rinick/hexomino/box/Hexomino_Box_V1.md

# 两片式拼图收纳盒 V1-S：单边折叠、两端纵向闭合

2026-10-23。A 为固定高端墙，B 保留一体打印折叠端墙。底板改为四处 A 定位舌上下交错半搭接，舌厚 2.1 mm、承托台阶厚 1.7 mm。固定端承托舌与另一端翻盖扣边共同限制上下分离，侧扣主要防止盒盖滑退。展开后 A 最高 **40 mm**、B 端墙折下后最高约 **23.4 mm**；拼图区上方仍无遮挡。当前为可试打机械设计。

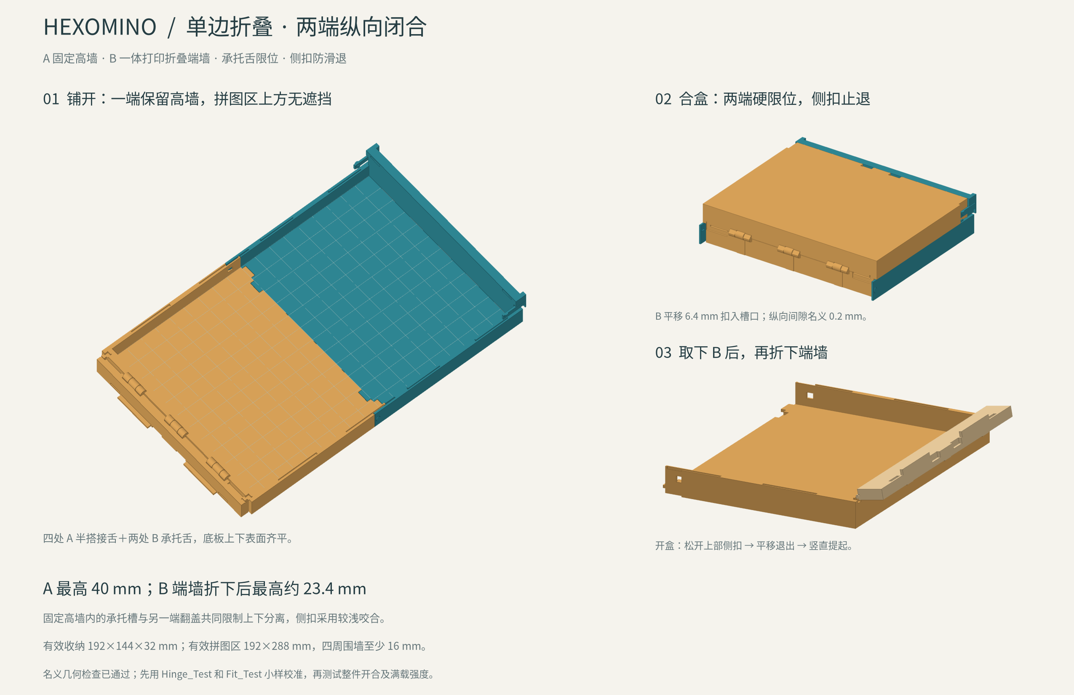
[picture p1: box/box_design.png]
拼板、闭盒和 B 端墙翻折


## 两片的形状

**A 是固定高墙托盘。** 底板 4 mm，两条长侧墙在底板以上高 16 mm，一条固定端墙到 Z=40 mm。固定墙的厚度内有两处承托台阶；墙的两侧各有一根上部弹臂，用于合盒止退。敞口处保留两根下部弹臂，用于拼板连接。

**B 是单边折叠托盘。** 底板和固定围墙与原版相同，端墙上半段由三组一体打印铰链连接。铺开时端墙向外翻下，固定围墙仍保留一格高度；合盒时端墙直立锁住，其扣边进入 A 底板的盲口。

A 为一个封闭实体；B STL 包含两个封闭壳体，即固定托盘和互锁的活动端墙。B 的塑料轴已经被轴套包住，不用金属轴或后装插销。正常打印不要把 B 两个壳体拆开重新摆盘或填掉活动缝。

整个 192×288 mm 拼图区底板以上没有内伸扣边、定位柱或连接件，所有拼块都能从正上方放入，包括跨接缝的位置。固定高墙上的承托槽位于 Y≥144 mm 的墙厚内，不伸进拼图区。

## 连接结构的分工

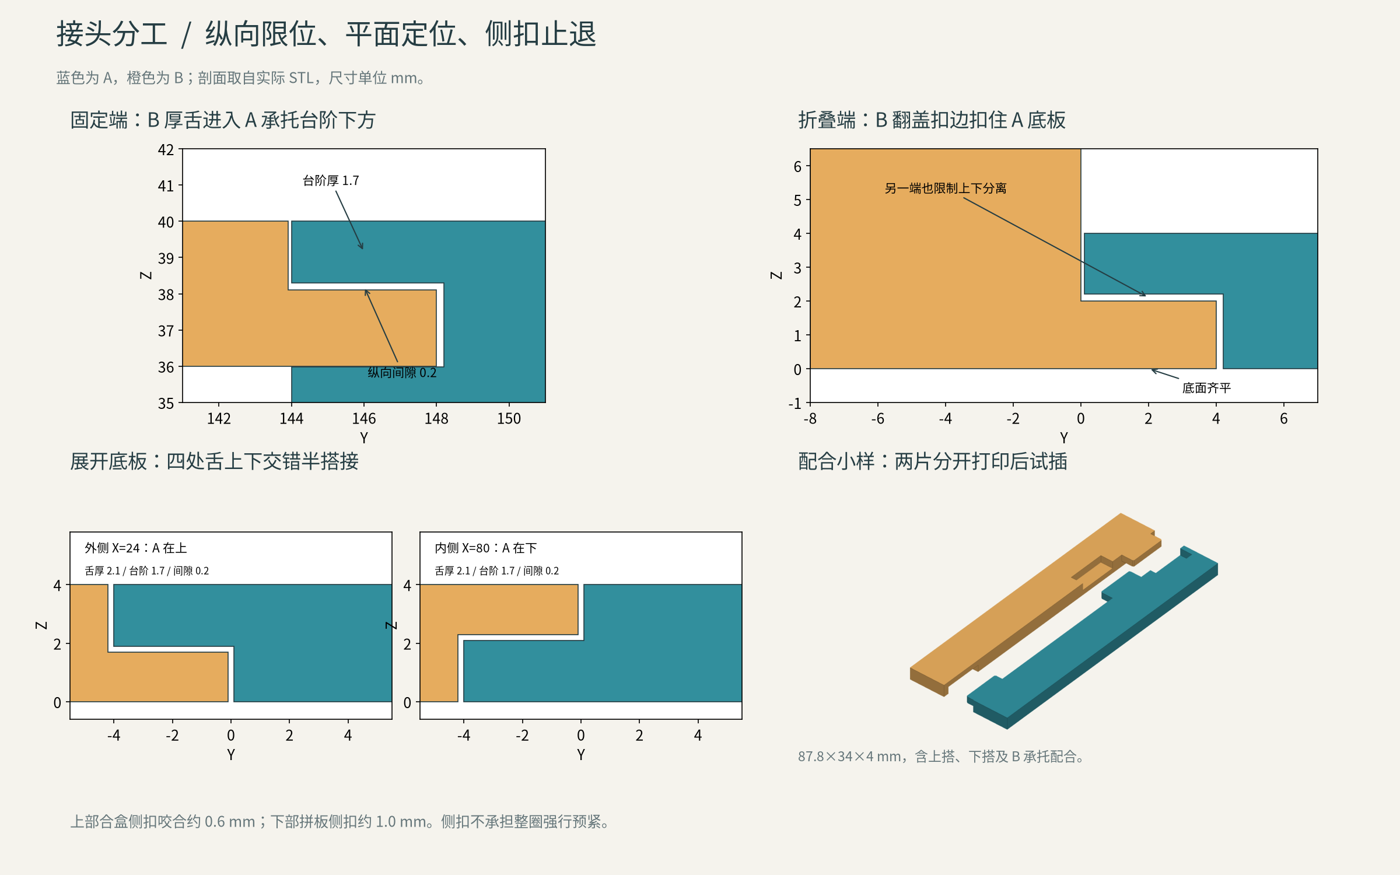
[picture p2: box/joints.png]
固定端承托、折叠端扣边与底板定位槽


| 结构 | 展开拼板时 | 合盒时 |
| --- | --- | --- |
| A 的四处矩形定位舌 | 与 B 底板的上下开放台阶半搭接，对齐接缝、限制错台 | 进入 B 端墙的让位口；开盖平移时退出 |
| B 的两处矩形承托舌 | 搭在 A 底板的下部台阶上，辅助定位 | 插到 A 固定高墙的承托台阶下方，限制上抬 |
| B 活动端墙的两段宽扣边 | 端墙折到外侧，不进入拼图区 | 扣住 A 底板的盲口，与固定端共同提供纵向闭合 |
| A 下部两只侧扣 | 扣入 B 的侧槽，防止拼板拉开 | 保持原位，不用于合盒止退 |
| A 上部两只侧扣 | 留在固定高墙外侧 | 复用 B 的同一组侧槽，主要防止 B 滑退 |
| 长侧墙的直舌和凹槽 | 位于围墙上缘 | 引导两片对齐，允许 6.4 mm 开盖平移 |

**纵向闭合由刚性承靠面承担。** 固定端的两处 B 舌翻面后位于 A 高墙承托台阶下方，台阶厚 1.7 mm，限制 B 上抬；另一端的翻盖扣边扣住 A 底板。长侧墙的合拢承靠面限制 B 下沉。两端防上抬配合的名义间隙都约 0.20 mm。这是留隙限位，不是依靠弹片强行预紧整盒；实际松紧需试打校准。

**侧扣负责止退。** 下部拼板侧扣的横向咬合约 1.0 mm，保留原强度定位。上部合盒侧扣咬合改为约 0.6 mm，释放行程约 0.8 mm；增加导入斜面，目标是减轻解扣力度。弹片实际力和寿命尚未做载荷验证。

**底板矩形舌作定位和错台限位。** A 四处舌中心位于 X=24、80、112、168 mm，左右对称并避开翻盖扣边。外侧两处在底板上部（Z=1.9–4 mm），内侧两处在下部（Z=0–2.1 mm）；对应 B 台阶分别在下方和上方，交错限制相对上抬和下沉。B 两处承托舌仍位于 X=8、184 mm，均在底板上部。所有矩形舌宽 12 mm、伸出 4 mm、厚 2.1 mm；对应台阶厚 1.7 mm，接触方向留 0.20 mm 间隙，即 2.1+0.2+1.7=4 mm。

原来的中置薄舌和全包盲槽改为单面开放搭接，端部保留平面导入倒角，没有梯形倒扣。舌的厚度略大于台阶，台阶仍保留 1.7 mm；不通过继续削薄台阶来增厚舌头。搭接后的顶面和底面与 4 mm 底板齐平，只有配合缝，不在拼图面增加凸起。底板搭接负责定位，主要抗拉连接仍由侧扣承担。

## 开合和转换顺序

**组成拼图板**：把空 B 正放在桌面，解开它的端墙弹片并向外折下；将 B 在板面内转 180°，与 A 敞口相对；沿桌面靠拢，让上下交错的矩形舌与台阶搭接，直到左右下部侧扣进入 B 窗口。两块 4 mm 底板齐平，中央接缝约 0.2 mm。解除时，拨开下部两只侧扣后沿板面拉开，不要直接向上掰接缝。

**组成收纳盒**：先分开拼板，按两层排布将全部拼块装入 A；把 B 活动端墙翻起，确认两端弹片锁住，再将空 B 翻面。B 相对最终位置向开口外侧错开约 6.4 mm，水平放到 A 上，对准长边导向槽；再沿板面滑入 6.4 mm，让固定端承托舌、另一端扣边和底板定位舌分别进入槽口，上部侧扣扣入 B 窗口。上部侧扣的导入面用于让位，必要时轻拨弹臂辅助扣合。

**开盒**：水平放置盒子，拨开 A 的两只上部侧扣，将 B 向开口外侧滑出约 6.4 mm，再竖直提起 B。取下 B 后，按需要翻面并折下它的端墙。闭盒时保持 B 端墙锁住，不直接翻它来开盒；否则矩形定位舌和扣边仍在槽内。

B 仍是浅托盘，开盖时上层拼块没有四面两格高的完整围墙包住，因此需要水平开盒。收纳沿用 [两层排布图](packing_12x9x2.png) 和 [排布数据](packing_12x9x2.json)：下层 19 块、上层 18 块，各 108 格。37 个拼块及每面 0.10 mm 打印间隙不变。

## B 的一体打印铰链

沿端墙分布三组铰链，中心 X=40、96、152 mm。塑料轴最大直径 2.4 mm，轴套圆孔直径 3.2 mm，最小径向和轴向间隙均约 0.40 mm。打印姿态已把端墙折下，孔顶采用约 45° 尖顶；轴下侧切平，仍需完成约 10 mm 的短桥接。

活动片上的三条筋接触打印床，支承活动轴套。两端弹片锁住直立位置；解扣后弹片沿限位台外侧滑开。打印活动间隙和释放力需先用 `Hinge_Test.stl` 校准。

## 尺寸

| 项目 | 尺寸 |
| --- | --- |
| 合盒完整有效空间 | 192×144×32 mm，12×9×2 格 |
| 展开拼图有效区域 | 192×288 mm，12×18 格 |
| 底板 / 长侧墙厚度 | 4 / 4 mm |
| 端墙主体厚度 | 8 mm |
| 围墙在底板以上的高度 | 至少 16 mm，A 固定端墙为 36 mm |
| A 单件打印外包 | 约 202.0×169.6×40 mm |
| B 单件打印外包，端墙折下 | 约 200.0×168.8×23.4 mm |
| 合盒外包，含侧面突出结构 | 约 202.0×169.6×40 mm |
| 展开外包，含折下端墙 | 约 202.0×320.4×40 mm |
| A 定位舌数量 | 4，外侧两处上搭、内侧两处下搭 |
| 矩形舌宽度 / 伸出 / 厚度 | 12 / 4 / 2.1 mm |
| 底板对应台阶 / 固定高墙承托台阶厚度 | 均为 1.7 mm |
| 搭接方向间隙 | 0.20 mm |
| 铰链小样 | 约 64×36.8×23.4 mm |
| 矩形配合小样 | 约 87.8×34×4 mm，两片分开放置 |

闭盒上下大面仍为 Z=0 和 40 mm 的平面，槽口处保留配合缝；侧面允许铰链、弹片和端墙支承凸出。

## 打印与试打

先打印 `STL/Hinge_Test.stl` 和 `STL/Fit_Test.stl`，使用与主体相同的材料、喷嘴和层高。前者含一组 B 铰链、端墙锁扣和一处定位舌让位口；后者含 A 上搭舌、下搭舌，以及 B 承托舌与对应台阶，两块小样已经分开放置，打印后沿板面试插。

A、B 都按 STL 当前姿态打印，底板外表面朝下。**A 上部两根水平弹臂下方需要局部、可清理的支撑**；弹臂底部位于 Z=25.6 mm，根部与固定墙连接。清理后检查弹臂下方、背后和上方间隙，不能把弹臂与周围墙面补实。可先在切片软件截取上部侧扣区域试打，检查支撑能否完整去除和约 0.8 mm 的释放行程。

下部定位舌接触打印床；A 的两处上部定位舌、B 的两处承托舌底面在 Z=1.9 mm，向外悬挑 4 mm，需按实际切片检查并添加可清理的局部支撑。固定高墙承托台阶的底面也需检查桥接和支撑效果。不得将搭接间隙填实。

B 的铰链活动缝内不要布支撑。检查塑料轴的短桥接和轴套孔顶，不能将两个活动壳体布尔合并。配合受材料和设备影响，需要小样迭代校准，参见 [Prusa 打印建模说明](https://help.prusa3d.com/article/modeling-with-3d-printing-in-mind_164135)。

完成小样后再打印完整主体，依次检查空盒滑入退出、两端纵向间隙、侧扣释放、满载拿取及反复开合。本文的刚性分工是几何设计，尚不代表已验证的满载强度或疲劳寿命。

## 几何验证与文件

`validation_results.json` 保存源码及四个 STL 的 SHA-256，验证内容为：

- A 一个、B 两个、两种小样各两个封闭且法向一致的壳体。
- 合盒、展开状态的顶点分层中点截面无实体面积重叠，截面数量记录在报告中。
- 实测四处 A 舌厚 2.1 mm、对应台阶厚 1.7 mm、间隙 0.20 mm；尝试将 B 上移和下移各 0.25 mm，均出现预期接触，确认双向错台限位。
- 取下 B 后，端墙在 183 个角度的截面内无刚体干涉；解扣阶段用约 1 mm 弹片挠动近似。
- B 错位下放检查 61 个位置，平移闭合检查 33 个位置，合盒侧扣释放检查 9 个位置，均无干涉。
- 拼板滑入检查 49 个位置、侧扣释放检查 13 个位置，均无干涉。
- 完整收纳空间无侵入，192×288 mm 拼图区底板以上投影无遮挡。
- 在闭盒状态尝试把 B 上提 0.25 mm，固定墙槽顶出现预期接触，确认纵向硬止挡存在；这不是承载强度试验。

侧扣让位采用近似几何位移，没有模拟实际弹性形变、切片、收缩、磨损或载荷。源码仍为 `hexomino_box_v1.scad`；`view="board"`、`"box"`、`"folding"` 查看三种状态，`fold_angle` 仅影响 B。`component="fixed"`、`"flap"` 仅用于壳体检查，正常保持 `"all"`。

```sh
openscad --backend=CGAL --hardwarnings --export-format=binstl -D 'part="A"' -o box/STL/Tray_A.stl box/hexomino_box_v1.scad
openscad --backend=CGAL --hardwarnings --export-format=binstl -D 'part="B"' -o box/STL/Tray_B.stl box/hexomino_box_v1.scad
openscad --backend=CGAL --hardwarnings --export-format=binstl -D 'part="coupon"' -o box/STL/Hinge_Test.stl box/hexomino_box_v1.scad
openscad --backend=CGAL --hardwarnings --export-format=binstl -D 'part="fit_coupon"' -o box/STL/Fit_Test.stl box/hexomino_box_v1.scad
python box/validate_geometry.py
```

验证脚本需要 NumPy、trimesh、Shapely、SciPy。旧版可从 Git 历史查看，当前打印文件均在 `box/STL/`。
