rinick/hexomino/ALL_37_SHAPES.png

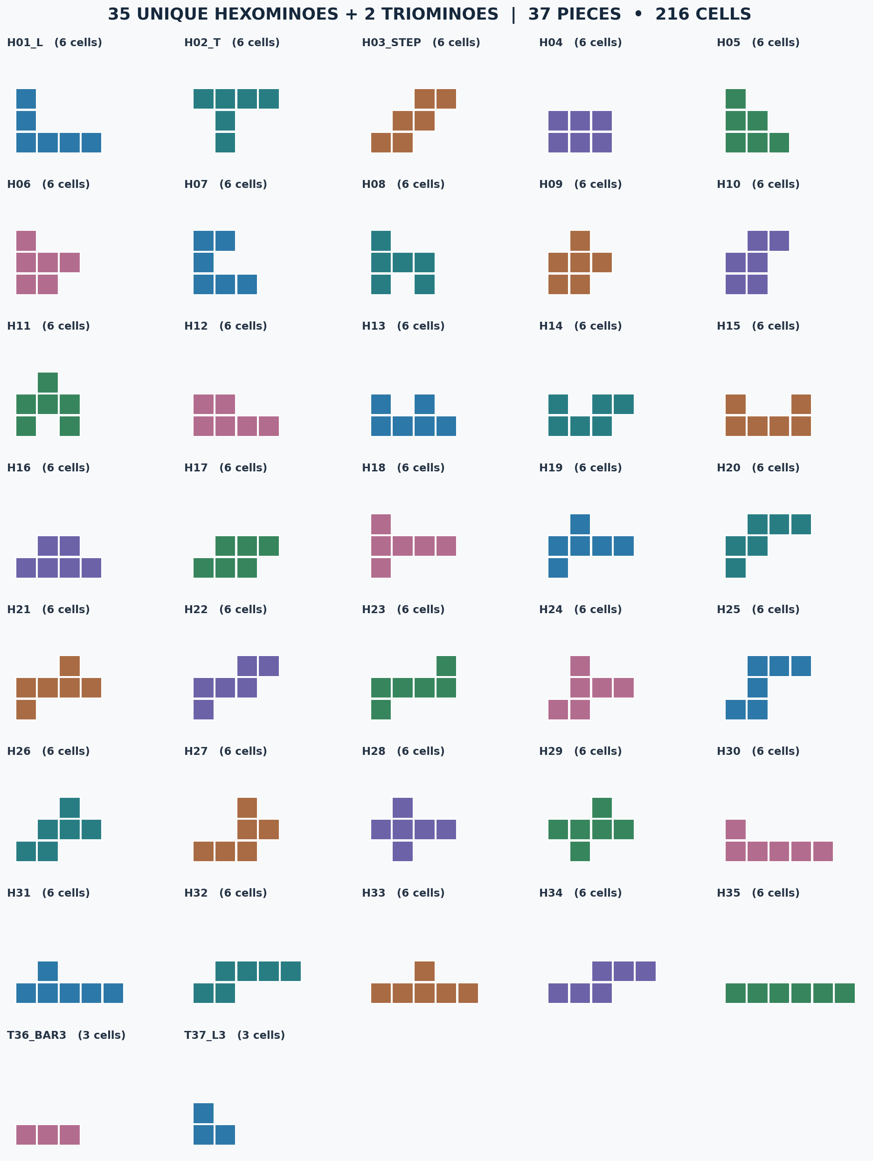
ALL_37_SHAPES.png
