rinick/hexomino/box/packing_12x9x2.png

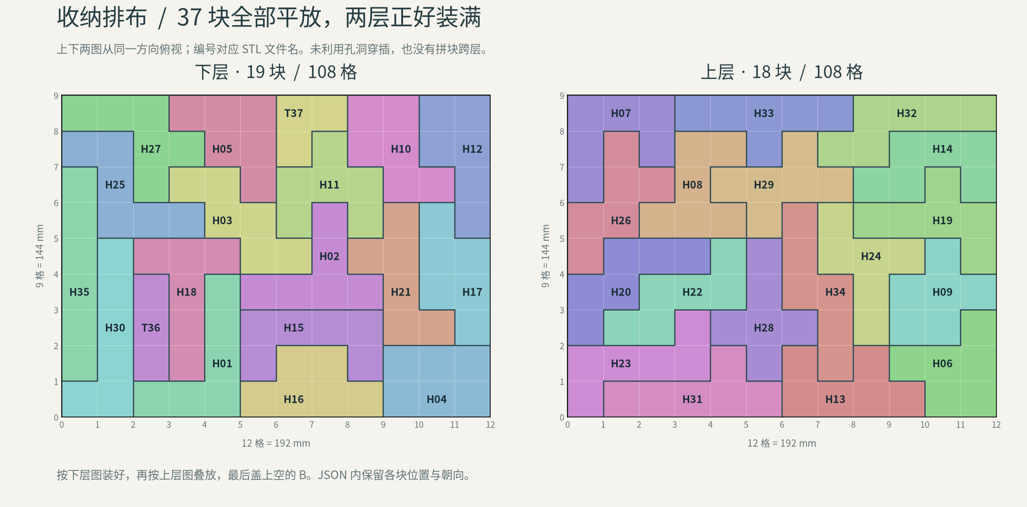
box/packing_12x9x2.png
