rinick/hexomino/V6_3_5_PREVIEW.png

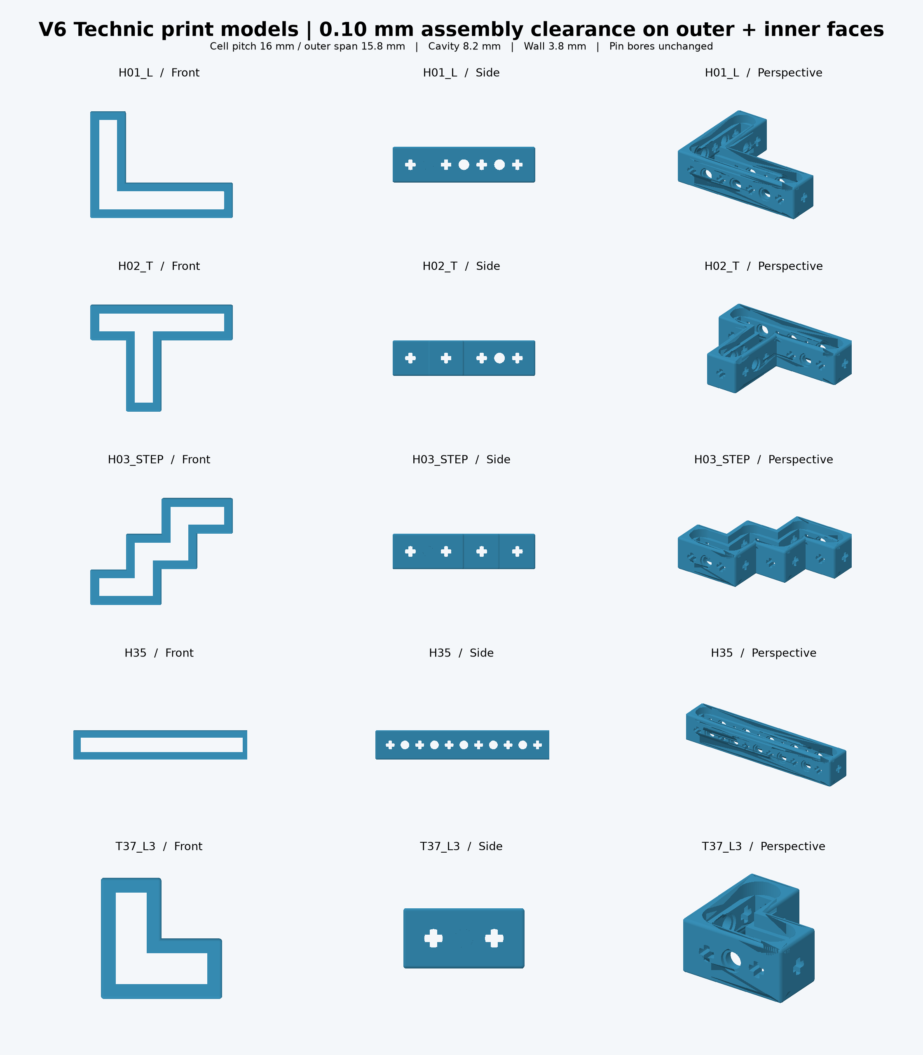
V6_3_5_PREVIEW.png
