rinick/hexomino/box/STL/Tray_A.stl

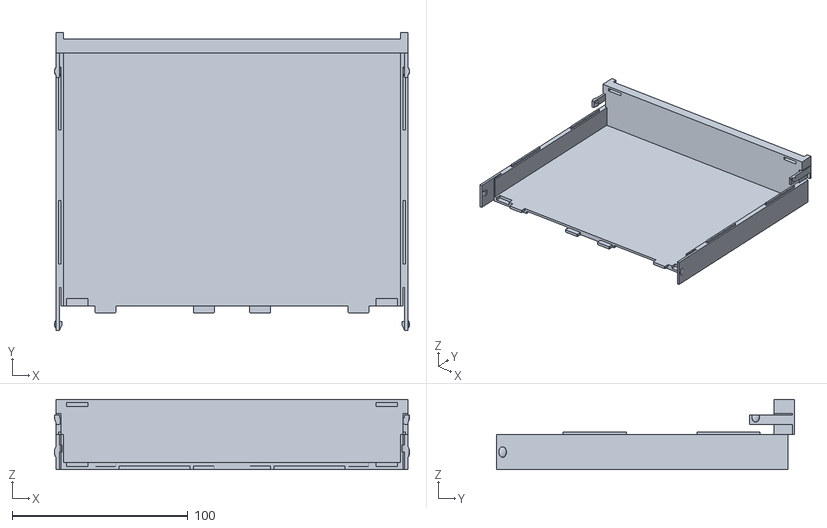
[picture p6: CAD file, 2026-10-23]
box/STL/Tray_A.stl
202.0 x 169.6 x 40.0
