rinick/hexomino/STL_37/T36_BAR3.stl

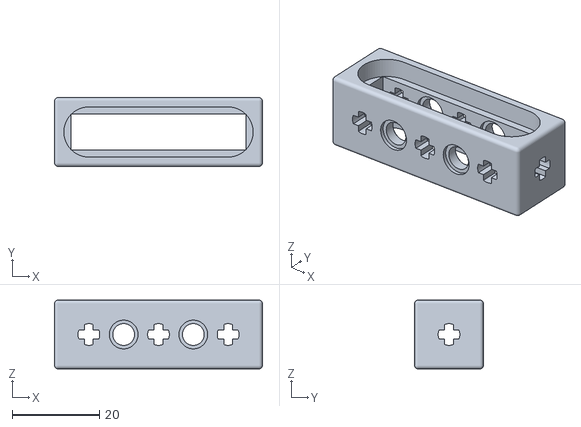
[picture p7: CAD file, 2026-10-23]
STL_37/T36_BAR3.stl
47.8 x 15.8 x 15.8
