rinick/hexomino/web/models/H08.stl

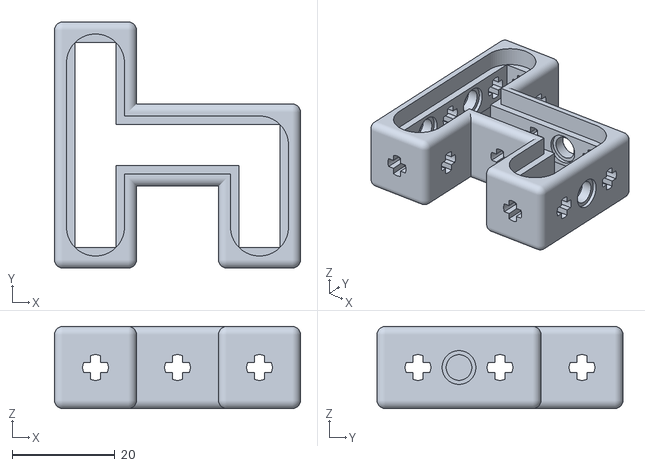
[picture p8: CAD file, 2026-10-23]
web/models/H08.stl
48.0 x 48.0 x 16.0
