rinick/hexomino/box/STL/Tray_B.stl

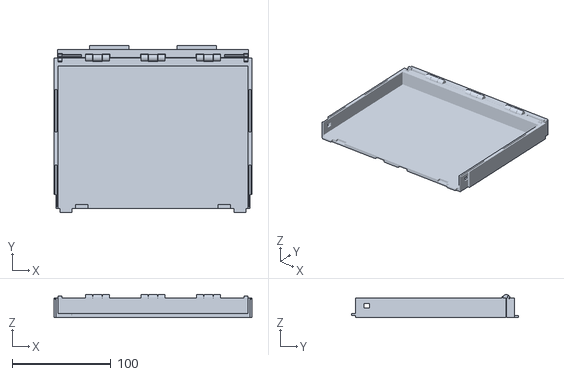
[picture p9: CAD file, 2026-10-23]
box/STL/Tray_B.stl
200.0 x 168.8 x 23.4
