rinick/hexomino/web/models/H30.stl

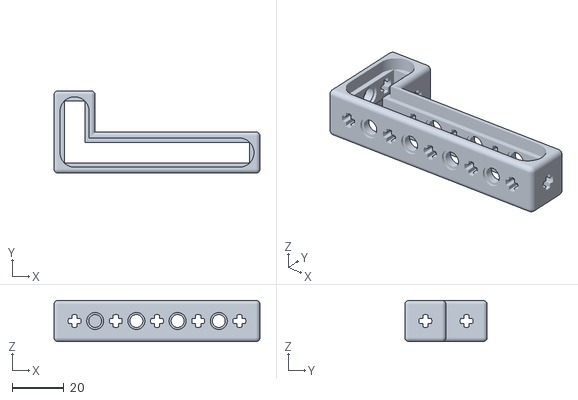
[picture p11: CAD file, 2026-10-23]
web/models/H30.stl
80.0 x 32.0 x 16.0
