rinick/hexomino/box/STL/Fit_Test.stl

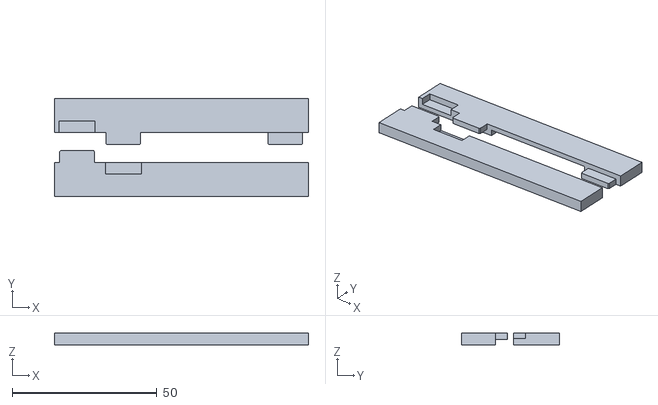
[picture p12: CAD file, 2026-10-23]
box/STL/Fit_Test.stl
87.8 x 34.0 x 4.00
