rinick/hexomino/STL_37/H20.stl

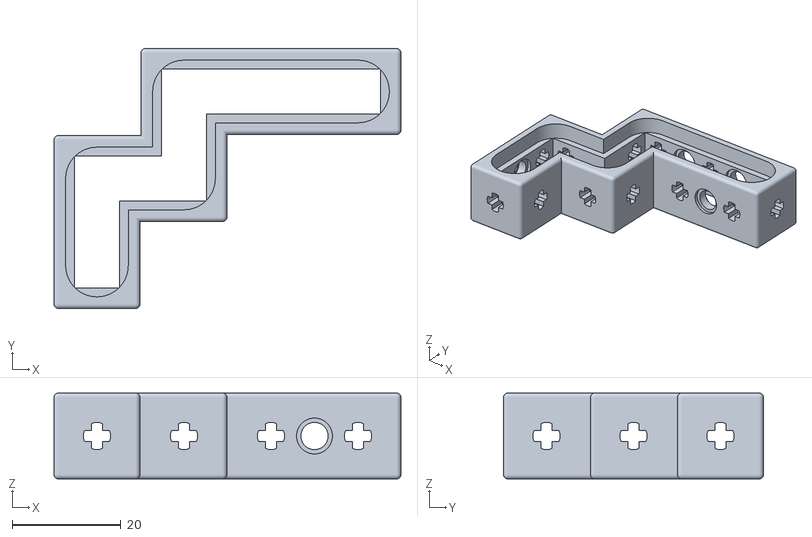
[picture p13: CAD file, 2026-10-23]
STL_37/H20.stl
63.8 x 47.8 x 15.8
