rinick/hexomino/web/models/H09.stl

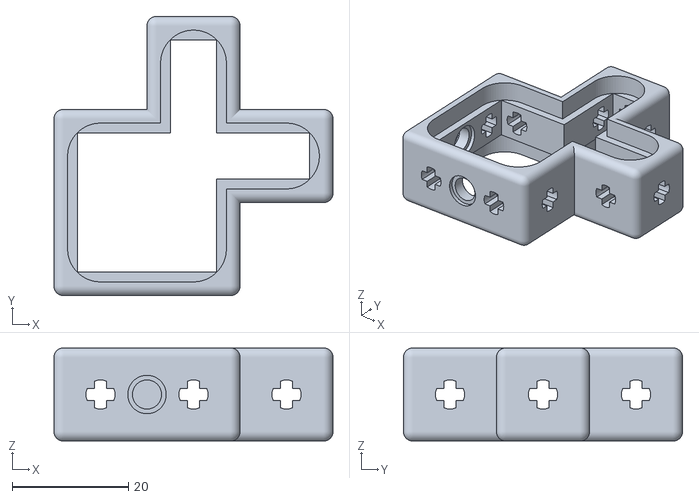
[picture p14: CAD file, 2026-10-23]
web/models/H09.stl
48.0 x 48.0 x 16.0
