rinick/hexomino/box/STL/Hinge_Test.stl

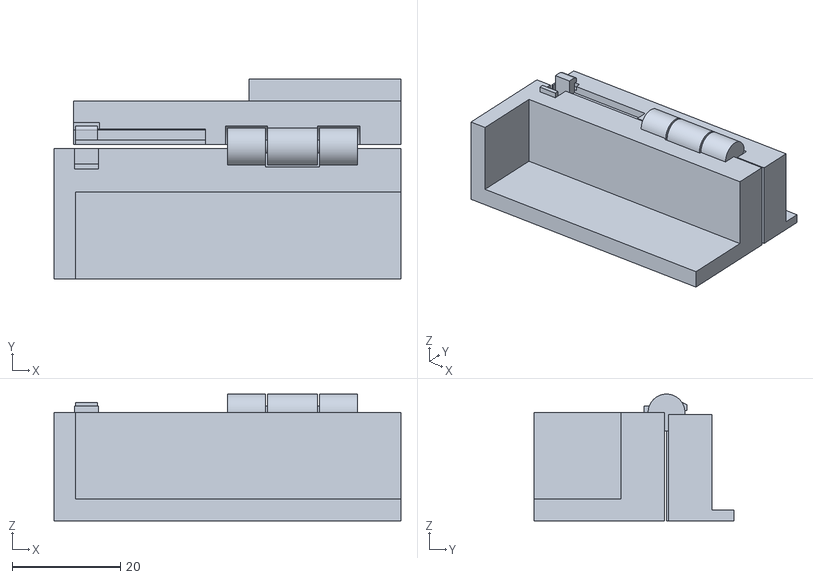
[picture p15: CAD file, 2026-10-23]
box/STL/Hinge_Test.stl
64.0 x 36.8 x 23.4
