rinick/hexomino/web/models/H28.stl

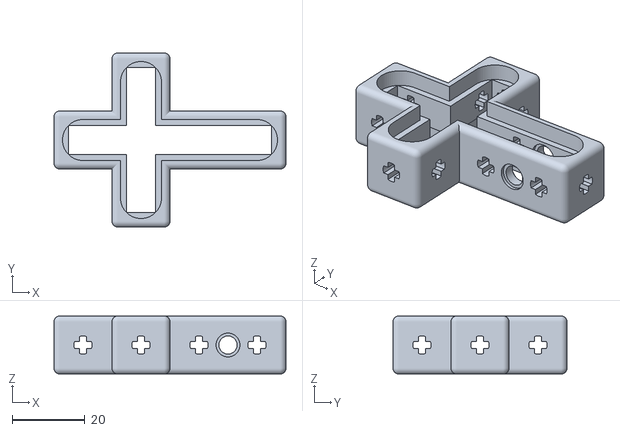
[picture p16: CAD file, 2026-10-23]
web/models/H28.stl
64.0 x 48.0 x 16.0
