rinick/hexomino/STL_37/H06.stl

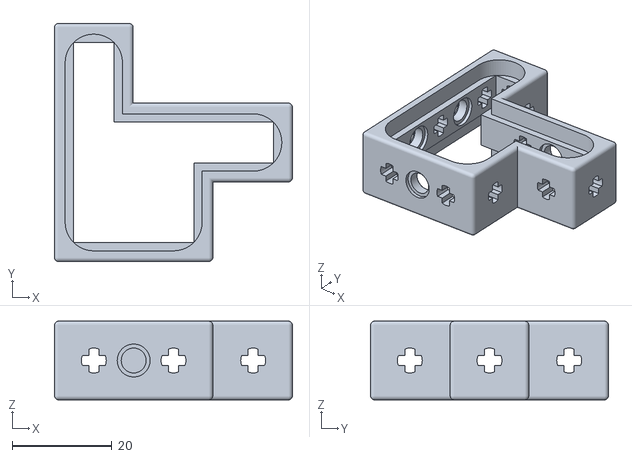
[picture p17: CAD file, 2026-10-23]
STL_37/H06.stl
47.8 x 47.8 x 15.8
