rinick/hexomino/STL_37/H31.stl

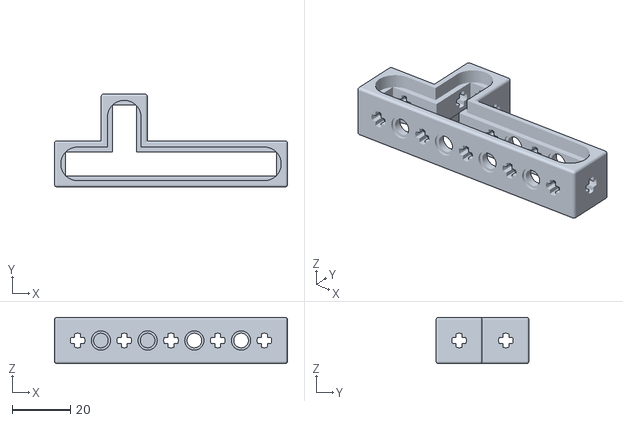
[picture p18: CAD file, 2026-10-23]
STL_37/H31.stl
79.8 x 31.8 x 15.8
