rinick/hexomino/STL_37/H13.stl

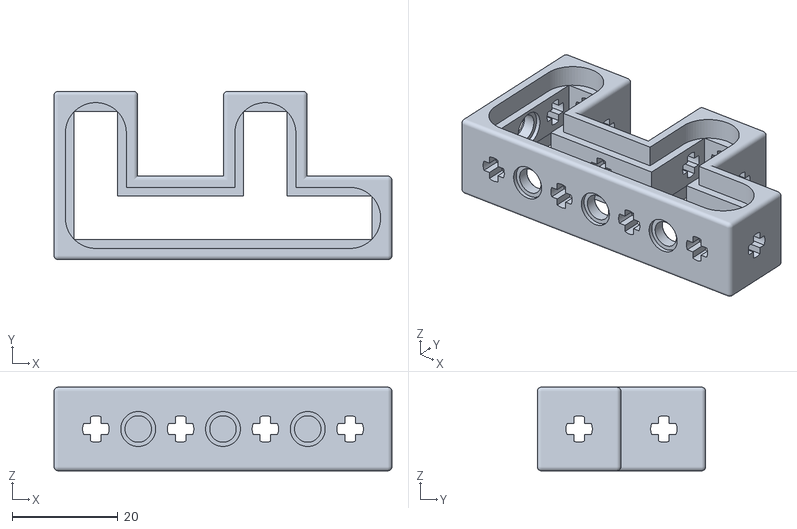
[picture p19: CAD file, 2026-10-23]
STL_37/H13.stl
63.8 x 31.8 x 15.8
