rinick/hexomino/web/models/H02_T.stl

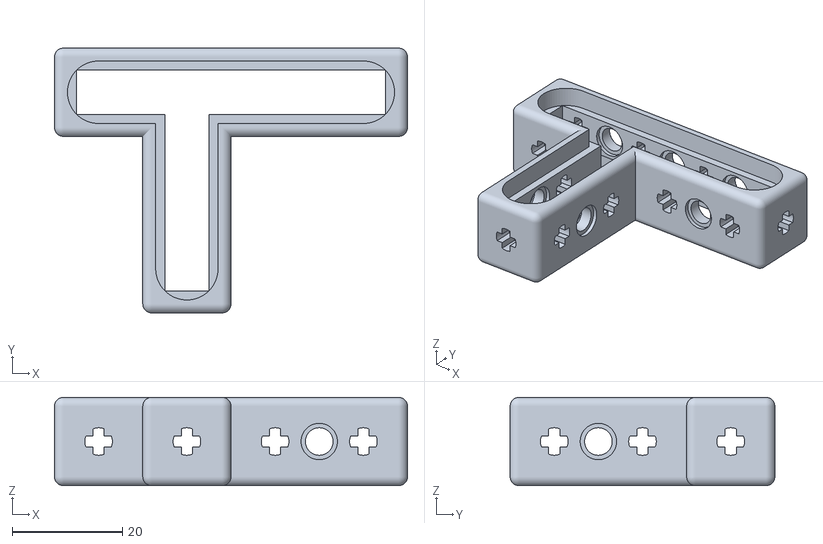
[picture p20: CAD file, 2026-10-23]
web/models/H02_T.stl
64.0 x 48.0 x 16.0
