rinick/hexomino/STL_37/H01_L.stl

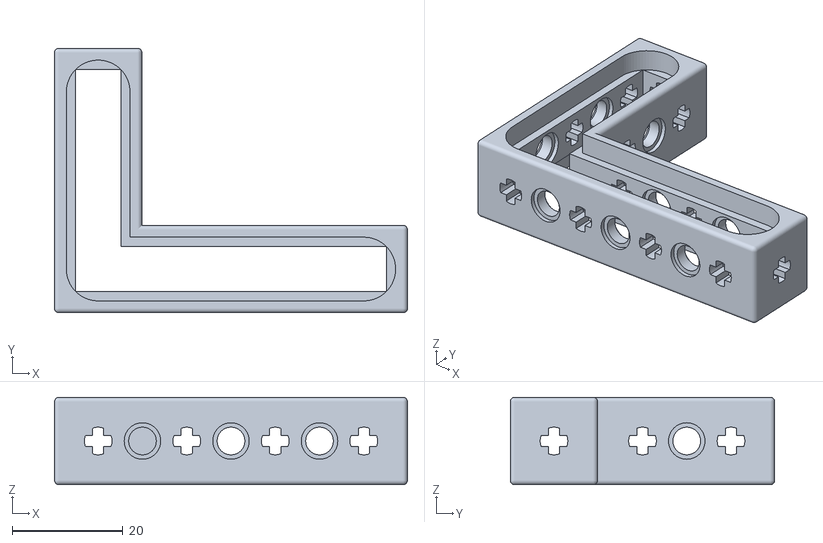
[picture p21: CAD file, 2026-10-23]
STL_37/H01_L.stl
63.8 x 47.8 x 15.8
