rinick/hexomino/web/models/T37_L3.stl

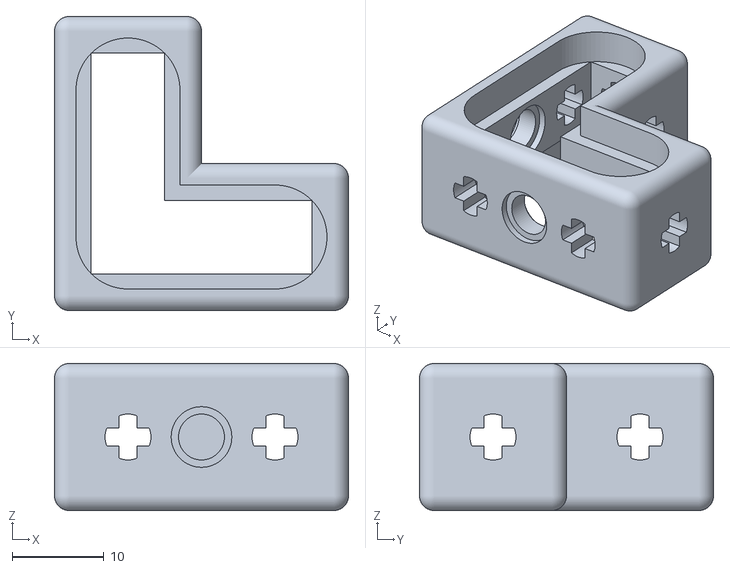
[picture p22: CAD file, 2026-10-23]
web/models/T37_L3.stl
32.0 x 32.0 x 16.0
