rinick/hexomino/web/models/H12.stl

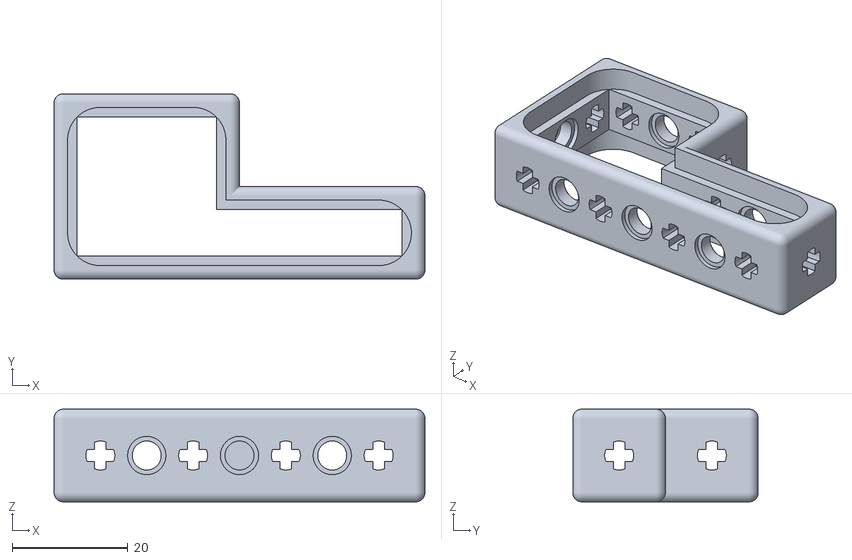
[picture p23: CAD file, 2026-10-23]
web/models/H12.stl
64.0 x 32.0 x 16.0
