rinick/hexomino/web/models/H35.stl

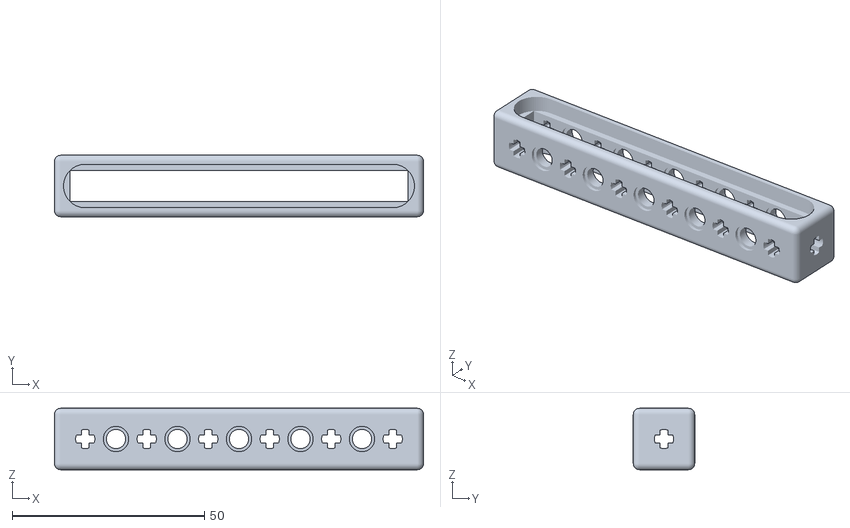
[picture p24: CAD file, 2026-10-23]
web/models/H35.stl
96.0 x 16.0 x 16.0
