rinick/hexomino/web/models/T36_BAR3.stl

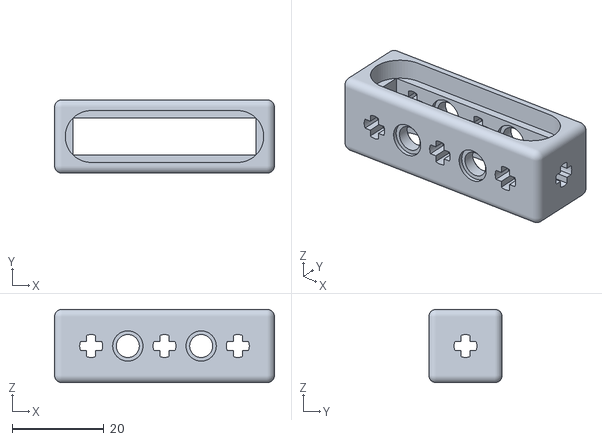
[picture p26: CAD file, 2026-10-23]
web/models/T36_BAR3.stl
48.0 x 16.0 x 16.0
