rinick/hexomino/web/models/H15.stl

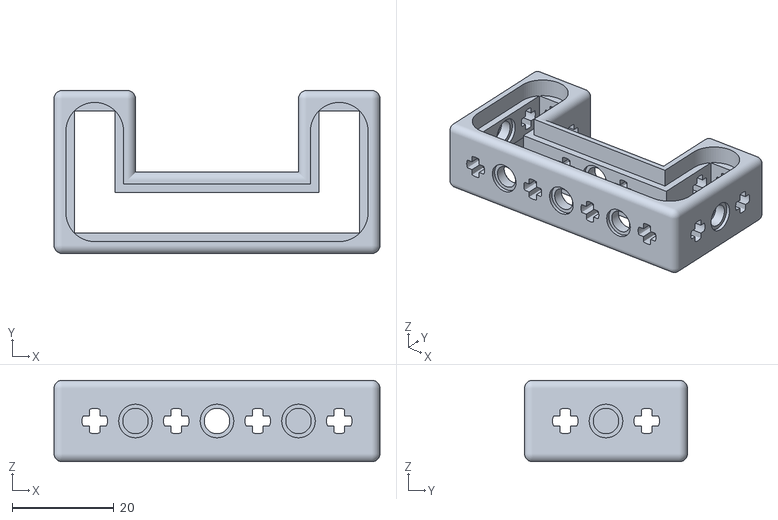
[picture p27: CAD file, 2026-10-23]
web/models/H15.stl
64.0 x 32.0 x 16.0
