rinick/hexomino/STL_37/H04.stl

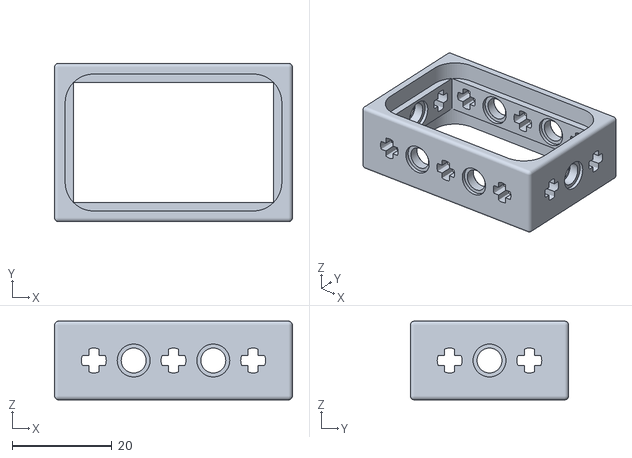
[picture p28: CAD file, 2026-10-23]
STL_37/H04.stl
47.8 x 31.8 x 15.8
