rinick/hexomino/web/models/H11.stl

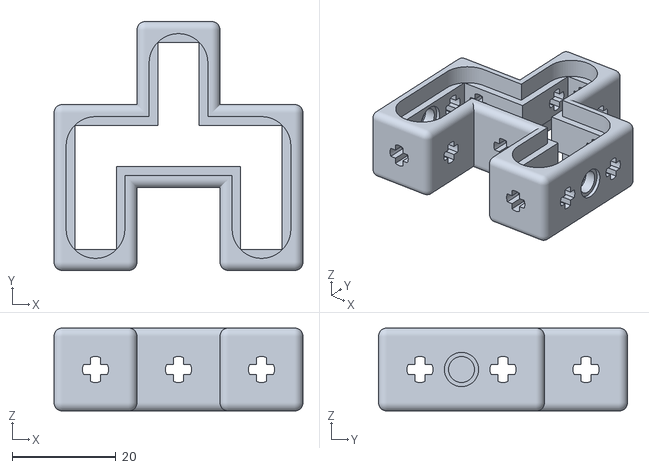
[picture p29: CAD file, 2026-10-23]
web/models/H11.stl
48.0 x 48.0 x 16.0
