rinick/hexomino/STL_37/H35.stl

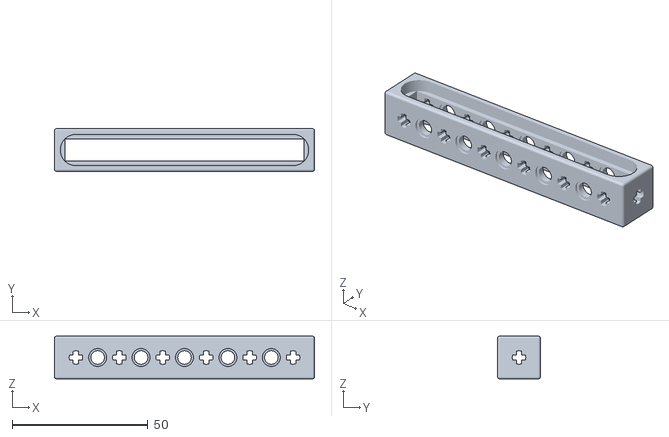
[picture p30: CAD file, 2026-10-23]
STL_37/H35.stl
95.8 x 15.8 x 15.8
