rinick/hexomino/(list of files, cad)

Other CAD files:
STL_37/H08.stl
web/models/H20.stl
web/models/H24.stl
web/models/H31.stl
STL_37/H26.stl
web/models/H26.stl
STL_37/H30.stl
web/models/H13.stl
STL_37/H05.stl
STL_37/H32.stl
web/models/H23.stl
STL_37/H21.stl
web/models/H14.stl
STL_37/H25.stl
web/models/H25.stl
web/models/H05.stl
STL_37/H19.stl
web/models/H17.stl
STL_37/H24.stl
web/models/H34.stl
STL_37/H02_T.stl
web/models/H29.stl
STL_37/H33.stl
STL_37/H17.stl
web/models/H27.stl
STL_37/H23.stl
STL_37/H03_STEP.stl
STL_37/H10.stl
STL_37/H09.stl
web/models/H19.stl
web/models/H33.stl
STL_37/H18.stl
web/models/H01_L.stl
STL_37/H29.stl
web/models/H22.stl
STL_37/H22.stl
web/models/H10.stl
STL_37/H27.stl
web/models/H16.stl
STL_37/H15.stl
web/models/H32.stl
STL_37/T37_L3.stl
web/models/H21.stl
STL_37/H34.stl
STL_37/H12.stl
web/models/H06.stl
STL_37/H14.stl
web/models/H07.stl
web/models/H03_STEP.stl
STL_37/H11.stl
web/models/H18.stl
STL_37/H28.stl
web/models/H04.stl
hexomino_local_half_cell_v6.scad
