rinick/hexomino/(commit log)

2026-10-18 feat: add STL-based hexomino puzzle studio
    [H01_L.stl, H02_T.stl, H03_STEP.stl, H04.stl, H05.stl, H06.stl, H07.stl, H08.stl]
2026-10-18 feat: round piece exterior edges to one tenth cell
    [H01_L.stl, H02_T.stl, H03_STEP.stl, H04.stl, H05.stl, H06.stl, H07.stl, H08.stl]
2026-10-19 feat: use 16mm Technic grid and axle holes
    Generate separate print and web STL sets with their respective exterior radii. Update the design plan, validation reports, previews, and viewer scaling.
    [H01_L.stl, H02_T.stl, H03_STEP.stl, H04.stl, H05.stl, H06.stl, H07.stl, H08.stl]
2026-10-23 feat: add two-part storage box and finalize printable geometry
    Add complementary trays that form a 12x18 puzzle board or a 12x9x2 storage box, with printable snap joints and a verified 37-piece packing layout.
    Include the pending Half Beam pin holes, enlarged face openings, uniform 0.1 mm print clearance, regenerated models and validation reports.
    [H01_L.stl, H02_T.stl, H03_STEP.stl, H04.stl, H05.stl, H06.stl, H07.stl, H08.stl]
2026-10-23 feat: add storage case with tall walls and clear top access
    [Tray_A.stl, Tray_B.stl, hexomino_box_v2.scad]
2026-10-23 feat: add print-in-place folding walls to original trays
    [Hinge_Test.stl, Tray_A.stl, Tray_B.stl, hexomino_box_v1.scad, hexomino_box_v2.scad]
2026-10-23 feat: add single folding wall and rigid case closure stops
    [Fit_Test.stl, Hinge_Test.stl, Tray_A.stl, Tray_B.stl, hexomino_box_v1.scad]
2026-10-23 feat: use four thicker half-lap alignment tongues
    [Fit_Test.stl, Hinge_Test.stl, Tray_A.stl, Tray_B.stl, hexomino_box_v1.scad]
